jonahsaunders/flyover_detector/(commit log)

2026-11-10 Add Tang Nano 20K flyover filter firmware and setup guide
2026-11-11 Add Tiny Tapeout SKY130 flyover audio filter
    Track falling audio tones and attenuate their fundamental and harmonics in a streaming I2S design. Add the SKY26e physical build, precheck, datasheet, and simulation workflows.
2026-11-11 Allow late I2S ADC data to settle before capture
    Sample after BCLK has risen, accounting for the input synchronizer. Exercise an ADC with 18 ns of setup in the pin-level testbench.
2026-11-11 Drive gate-level power ports through supply nets
2026-11-11 Repair loaded nets after global routing
    Check resizer decisions against the slow and fast extraction corners and repair slew and capacitance with global-route parasitics.
